braingeneers/incubatormicroscopesupplement/CAD/flatparts/bigbase_xyz.dxf

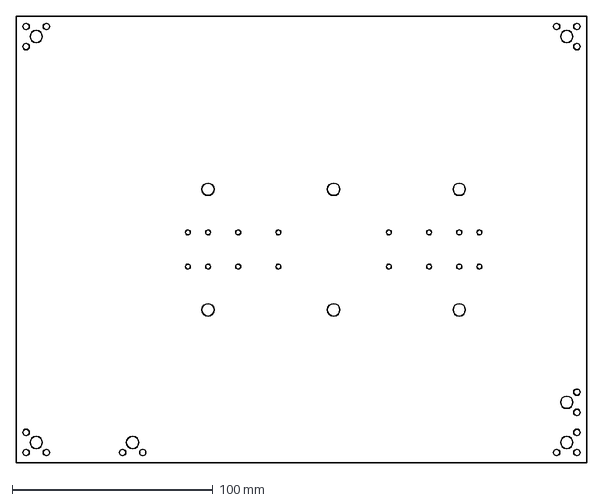
[picture p1: CAD file, 2026-02-16]
CAD/flatparts/bigbase_xyz.dxf
284.0 x 222.0 mm
