braingeneers/incubatormicroscopesupplement/CAD/flatparts/endstopholder_XYZ.dxf

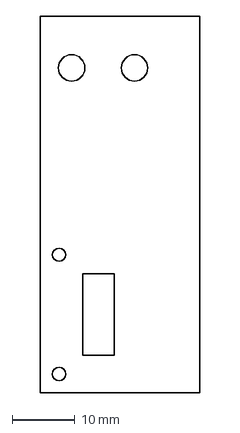
[picture p1: CAD file, 2026-02-16]
CAD/flatparts/endstopholder_XYZ.dxf
25.4 x 60.0 mm
